LowPower-LPWA/kicad_ml7404/ml7404_rev0/ml7404_rev0.pdf

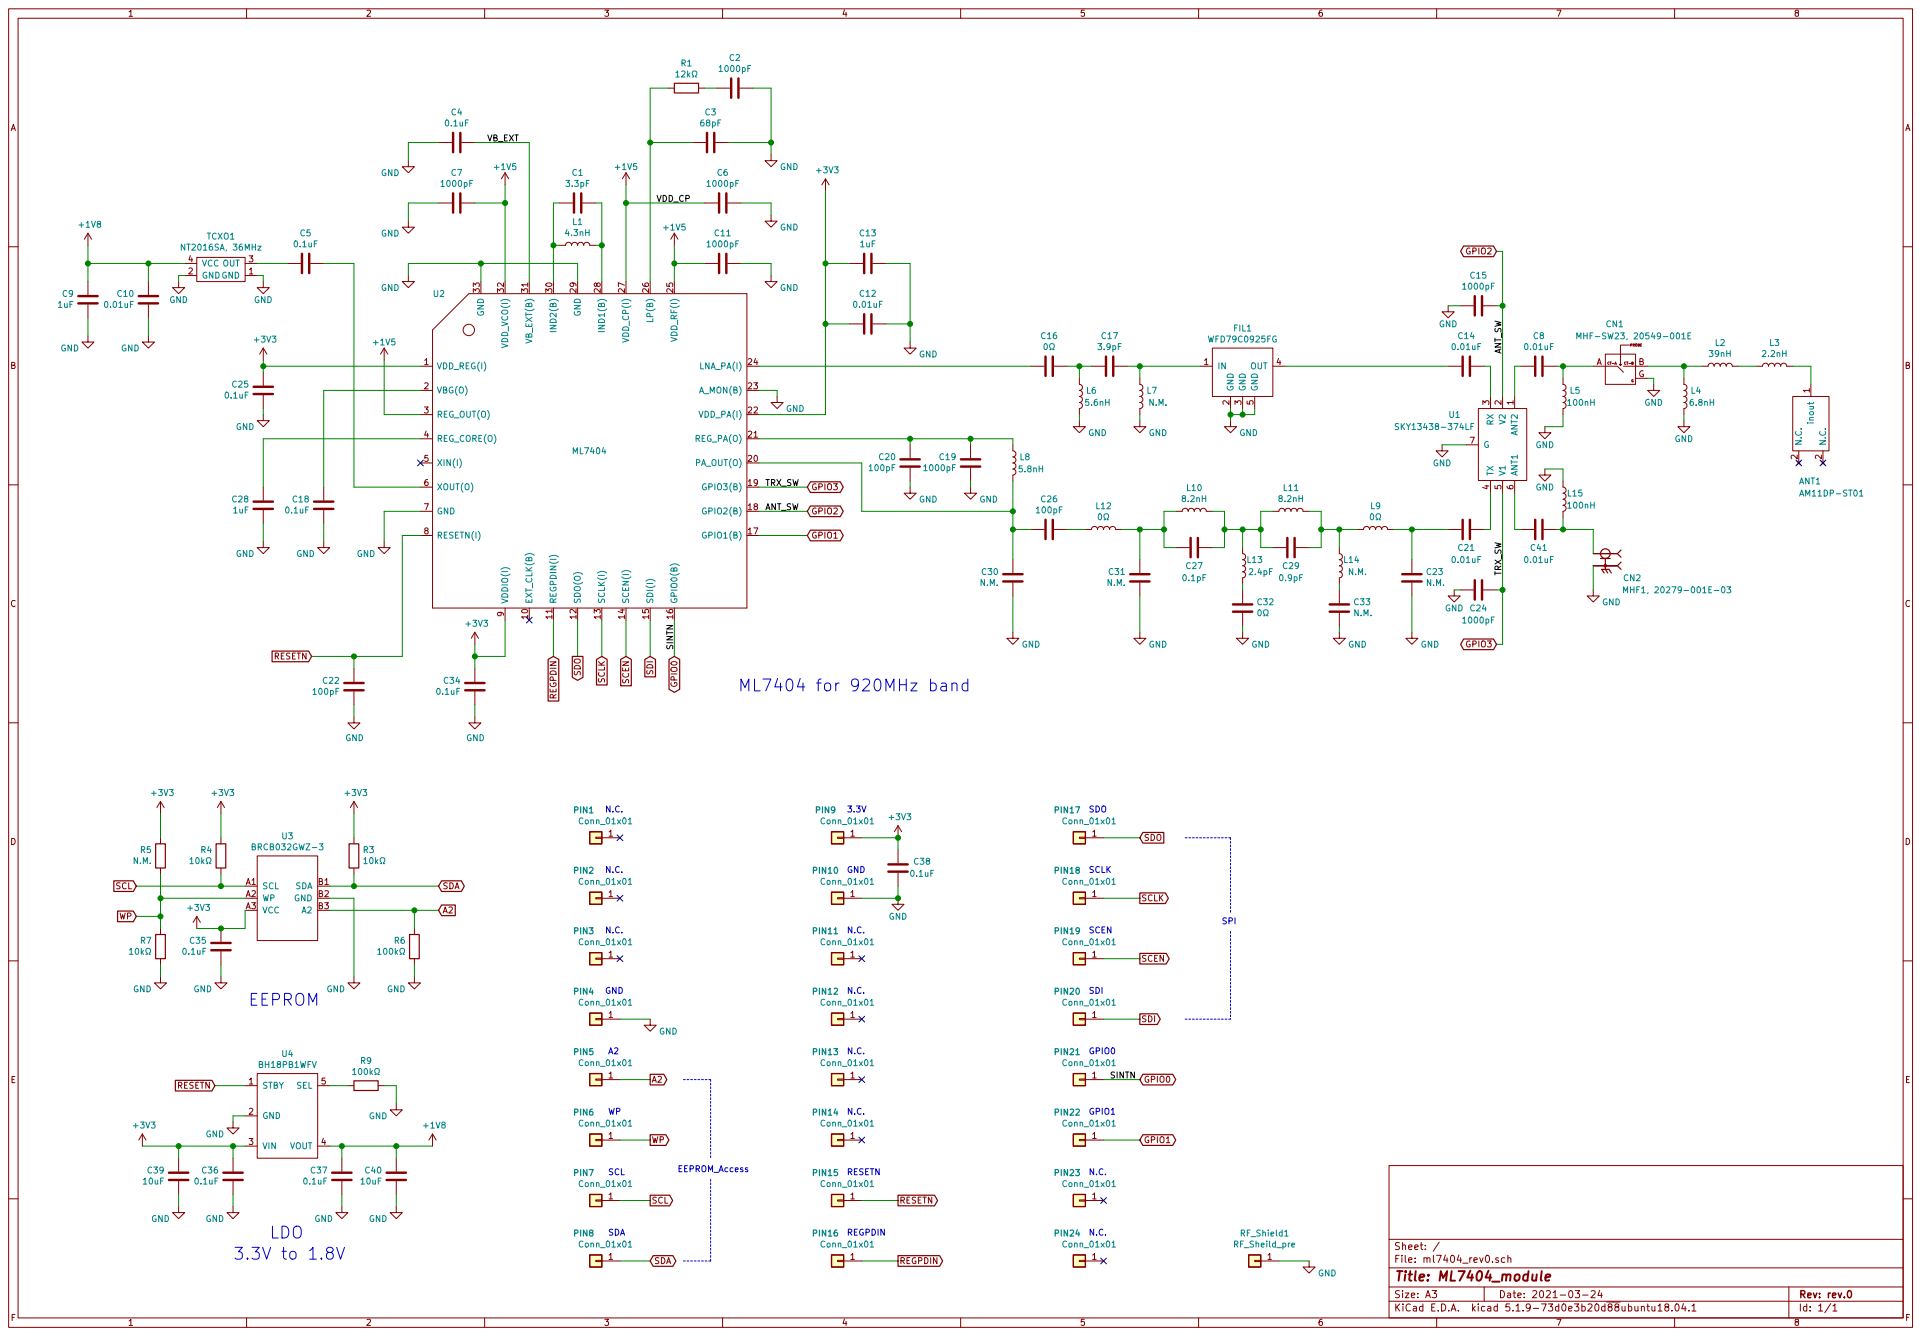
[picture p1: page 1]
