LowPower-LPWA/kicad_ml7404/ml7404_rev0/ml7404_rev0.kicad_pcb

## KiCad design ml7404_rev0/ml7404_rev0.kicad_pcb (2021-05-05)

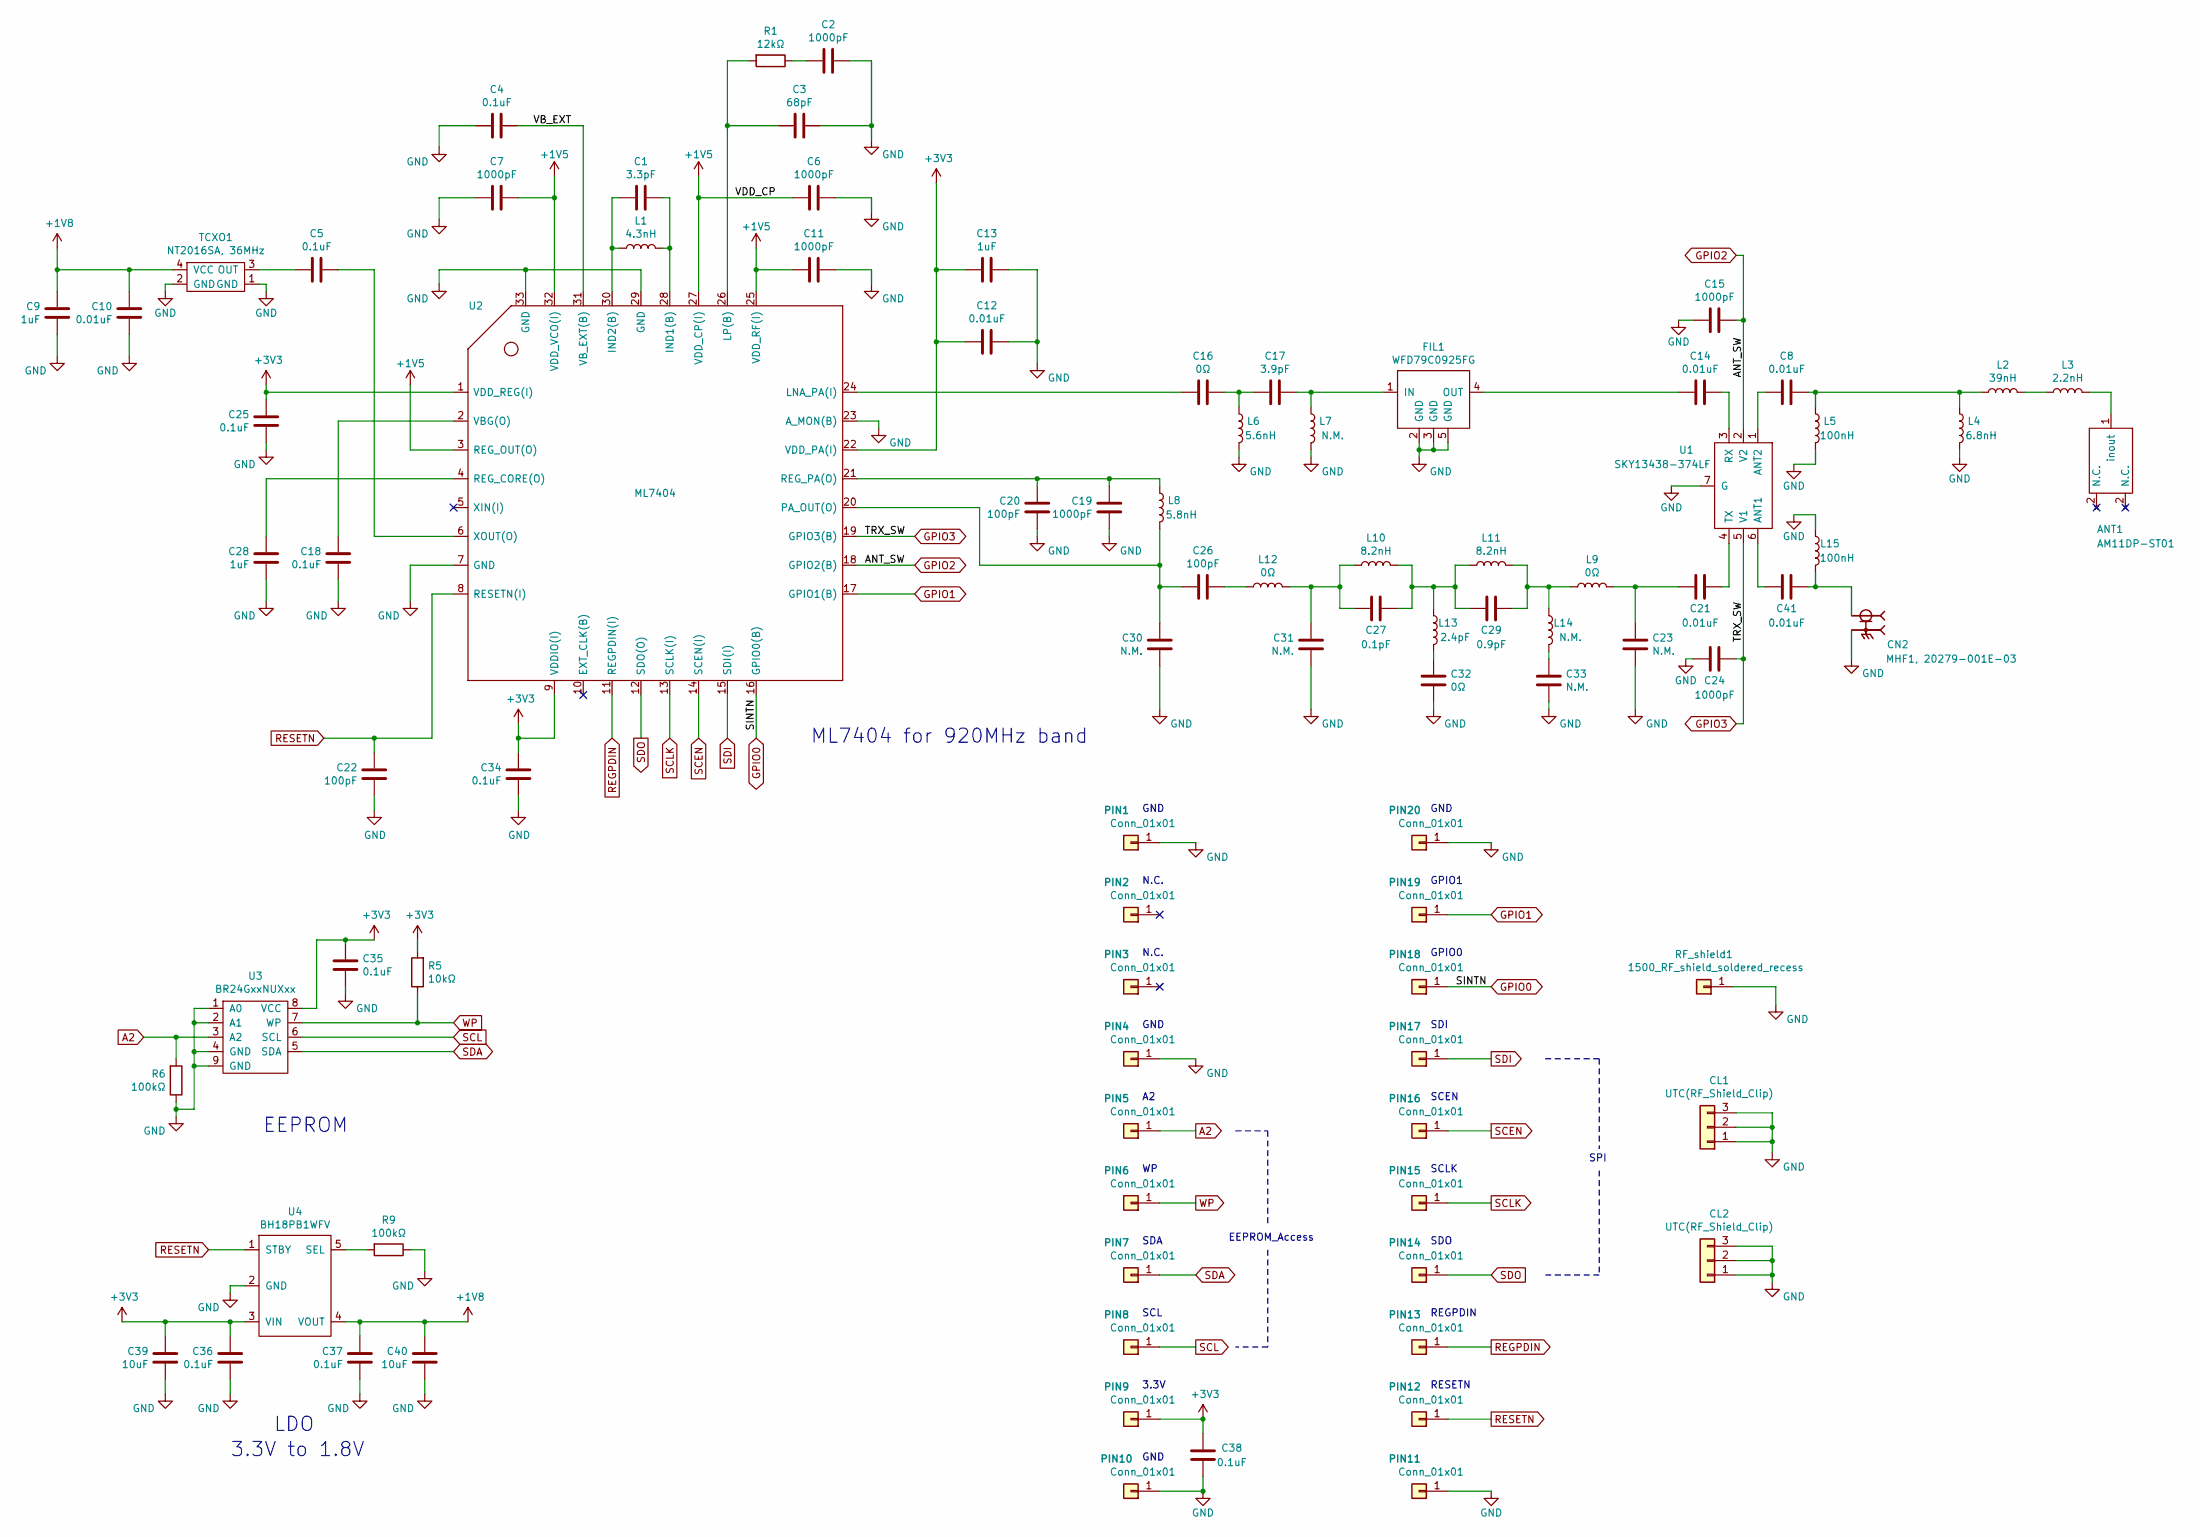
[picture p2: schematic ml7404_rev0.sch, ML7404_module]

Parts:
ANT1: AM11DP-ST01
C1: 3.3pF; C_0402_1005Metric
C2, C6, C7, C11, C15, C19, C24: 1000pF; C_0402_1005Metric
C3: 68pF; C_0402_1005Metric
C4, C5, C18, C25, C34, C35, C36, C37, C38: 0.1uF; C_0402_1005Metric
C8, C10, C12, C14, C21, C41: 0.01uF; C_0402_1005Metric
C9, C13, C28: 1uF; C_0402_1005Metric
C16, C32: 0Ω; C_0402_1005Metric
C17: 3.9pF; C_0402_1005Metric
C20, C22, C26: 100pF; C_0402_1005Metric
C23, C30, C31, C33: N.M.; C_0402_1005Metric
C27: 0.1pF; C_0402_1005Metric
C29: 0.9pF; C_0402_1005Metric
C39, C40: 10uF; C_0603_1608Metric
CL1, CL2: UTC(RF_Shield_Clip); UTC_RF_Shield_Clip
CN2: MHF1, 20279-001E-03; IPEX_20279-001E-03
FIL1: WFD79C0925FG
L1: 4.3nH; L_0402_1005Metric
L2: 39nH; L_0402_1005Metric
L3: 2.2nH; L_0402_1005Metric
L4: 6.8nH; L_0402_1005Metric
L5, L15: 100nH; L_0402_1005Metric
L6: 5.6nH; L_0402_1005Metric
L7, L14: N.M.; L_0402_1005Metric
L8: 5.8nH; L_0402_1005Metric
L9, L12: 0Ω; L_0402_1005Metric
L10, L11: 8.2nH; L_0402_1005Metric
L13: 2.4pF; L_0402_1005Metric
PIN1, PIN2, PIN3, PIN4, PIN5, PIN6, PIN7, PIN8, PIN9, PIN10, PIN11, PIN12, PIN13, PIN14, PIN15, PIN16, PIN17, PIN18, PIN19, PIN20: Conn_01x01; terminal
R1: 12kΩ; R_0402_1005Metric
R5: 10kΩ; R_0402_1005Metric
R6, R9: 100kΩ; R_0402_1005Metric
RF_shield1: 1500_RF_shield_soldered_recess; 1500_RF_Shield_soldered_30mmx25mm
TCXO1: NT2016SA, 36MHz; TCXO_2016SA
U1: SKY13438-374LF
U2: ML7404; ml7404
U3: BR24GxxNUXxx
U4: BH18PB1WFV; BH18PB1WHFV

Connections:
+1V5: C6.2, C7.1, C11.2, U2.3 (REG_OUT(O)), U2.25 (VDD_RF(I)), U2.27 (VDD_CP(I)), U2.32 (VDD_VCO(I))
+1V8: C9.2, C10.2, C37.2, C40.2, TCXO1.4 (VCC), U4.4 (VOUT)
+3V3: C12.2, C13.2, C25.2, C34.2, C35.2, C36.2, C38.2, C39.2, PIN9.1, R5.2, U2.1 (VDD_REG(I)), U2.9 (VDDIO(I)), U2.22 (VDD_PA(I)), U3.8 (VCC), U4.3 (VIN)
/VB_EXT: C4.1, U2.31 (VB_EXT(B))
A2: PIN5.1, R6.2, U3.3 (A2)
GND: C2.1, C3.1, C4.2, C6.1, C7.2, C9.1, C10.1, C11.1, C12.1, C13.1, C15.2, C18.1, C19.1, C20.1, C22.1, C23.1, C24.2, C25.1, C28.1, C30.1, C31.1, C32.1, C33.1, C34.1, C35.1, C36.1, C37.1, C38.1, C39.1, C40.1, CL1.1, CL1.2, CL1.3, CL2.1, CL2.2, CL2.3, CN2.2, CN2.3, FIL1.2 (GND), FIL1.3 (GND), FIL1.5 (GND), L4.2, L5.2, L6.2, L7.2, L15.1, PIN1.1, PIN4.1, PIN10.1, PIN11.1, PIN20.1, R6.1, R9.1, RF_shield1.1, TCXO1.1 (GND), TCXO1.2 (GND), U1.7 (G), U2.7 (GND), U2.23 (A_MON(B)), U2.29 (GND), U2.33 (GND), U3.1 (A0), U3.2 (A1), U3.4 (GND), U3.9 (GND), U4.2 (GND)
GPIO0: PIN18.1, U2.16 (GPIO0(B))
GPIO1: PIN19.1, U2.17 (GPIO1(B))
GPIO2: C15.1, U1.2 (V2), U2.18 (GPIO2(B))
GPIO3: C24.1, U1.5 (V1), U2.19 (GPIO3(B))
unnamed: ANT1.1 (inout), L3.2
unnamed: C1.1, L1.2, U2.28 (IND1(B))
unnamed: C1.2, L1.1, U2.30 (IND2(B))
unnamed: C2.2, R1.1
unnamed: C3.2, R1.2, U2.26 (LP(B))
unnamed: C5.1, U2.6 (XOUT(O))
unnamed: C5.2, TCXO1.3 (OUT)
unnamed: C8.1, L2.1, L4.1, L5.1
unnamed: C8.2, U1.1 (ANT2)
unnamed: C14.1, U1.3 (RX)
unnamed: C14.2, FIL1.4 (OUT)
unnamed: C16.1, C17.2, L6.1
unnamed: C16.2, U2.24 (LNA_PA(I))
unnamed: C17.1, FIL1.1 (IN), L7.1
unnamed: C18.2, U2.2 (VBG(O))
unnamed: C19.2, C20.2, L8.1, U2.21 (REG_PA(O))
unnamed: C21.1, U1.4 (TX)
unnamed: C21.2, C23.2, L9.2
unnamed: C26.1, L12.1
unnamed: C26.2, C30.2, L8.2, U2.20 (PA_OUT(O))
unnamed: C27.1, C29.2, L10.2, L11.1, L13.1
unnamed: C27.2, C31.2, L10.1, L12.2
unnamed: C28.2, U2.4 (REG_CORE(O))
unnamed: C29.1, L9.1, L11.2, L14.1
unnamed: C32.2, L13.2
unnamed: C33.2, L14.2
unnamed: C41.1, CN2.1, L15.2
unnamed: C41.2, U1.6 (ANT1)
unnamed: L2.2, L3.1
unnamed: R9.2, U4.5 (SEL)
REGPDIN: PIN13.1, U2.11 (REGPDIN(I))
RESETN: C22.2, PIN12.1, U2.8 (RESETN(I)), U4.1 (STBY)
SCEN: PIN16.1, U2.14 (SCEN(I))
SCL: PIN8.1, U3.6 (SCL)
SCLK: PIN15.1, U2.13 (SCLK(I))
SDA: PIN7.1, U3.5 (SDA)
SDI: PIN17.1, U2.15 (SDI(I))
SDO: PIN14.1, U2.12 (SDO(O))
WP: PIN6.1, R5.1, U3.7 (WP)

Notes on the sheet:
N.C.
GND
SCL
SDA
3.3V
EEPROM_Access
EEPROM
LDO
3.3V to 1.8V
ML7404 for 920MHz band
SCEN
SPI
GPIO1
GPIO0
SDI
SCLK
SDO
REGPDIN
RESETN

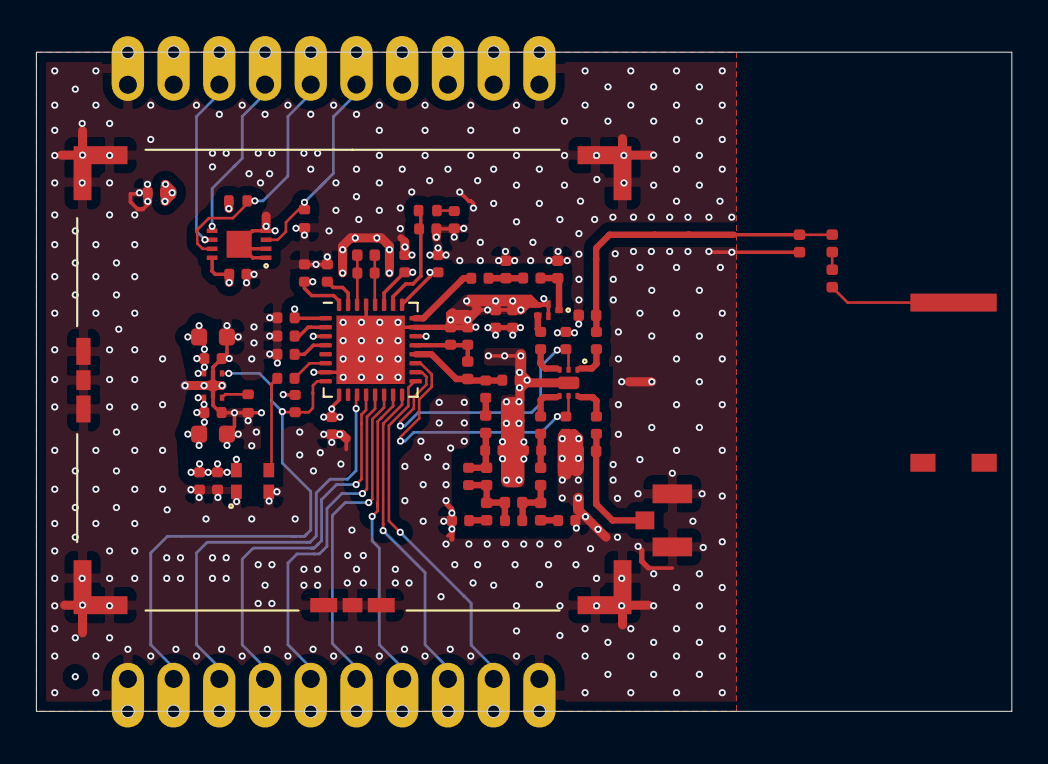
[picture p3: board ml7404_rev0.kicad_pcb from above]

Board: 4 copper layers, 54.2 x 36.6 mm, 91 parts (0 on the bottom side), 49 nets.
