LowPower-LPWA/kicad_ml7404/(commit log)

2021-02-28 just create project
    [ml7404_rev0.kicad_pcb, ml7404_rev0.sch]
2021-03-21 Pre layout
    [ml7404_rev0.kicad_pcb]
2021-03-24 adjusted RF shield footprint
    [ml7404_rev0.sch]
2021-03-24 added L4 mask
    [ml7404_rev0.kicad_pcb]
2021-03-25 .gitignoreに不要なファイルを追加
2021-04-10 pre layout2
    [ml7404_rev0.kicad_pcb, ml7404_rev0.sch]
2021-05-05 Minor change (Add GND VIA)
    [ml7404_rev0.kicad_pcb, ml7404_rev0.sch]
